pgorelik/NI_MyRIO_ExpansionBoard/README.md

# NI_MyRIO_ExpansionBoard
Breakout board with lick detection, solenoid driving and lights
