pgorelik/NI_MyRIO_ExpansionBoard/PCB-Eagle/MyRIO Expansion Board BOM Ver G2a.pdf

### MyRIO Expansion Board

(Gamma2a, 2018)

Name | Value | Package | Description | Part Number
C1, C2, C3 | 220 uF (50V) | Radial | Buckpuck cap | P5183-ND
C4, C5, C8, C9 | .1 uF? | 0805 | LP filter
C6 | .1 uF | Radial | Vreg output cap
C7 | .33 uF 50V | Radial | Vreg input cap
C10 | .1 uF | 0805 | Comparator bypass cap
D1 | 2A, 200V | Through hole | Input reverse polarity protection diode | RL203-TPCT-ND (http://www.digikey.com/product-detail/en/micro-commercial-co/RL203-TP/RL203-TPCT-ND/950500)
D2, D3 | 1A, 100V | SMB | SB1100 solenoid flyback Schottky diode | MBRS1100T3GOSCT-ND (https://www.digikey.com/product-detail/en/on-semiconductor/MBRS1100T3G/MBRS1100T3GOSCT-ND/917998)
D2, D3 | 3A, 60V | SMB | Fast recovery Schottky diode for coils. MBRS360 | MBRS360BT3GOSCT-ND (https://www.digikey.com/product-detail/en/on-semiconductor/MBRS360BT3G/MBRS360BT3GOSCT-ND/2623453)
D4, D5 | 40V | SOT23 | Lick FET Protection Schottky diode | BAS40-04-E3-08CT-ND (https://www.digikey.com/product-detail/en/vishay-semiconductor-diodes-division/BAS40-04-E3-08/BAS40-04-E3-08CT-ND/3104412)
D4, D5 | 40V | SOT23 | Upgraded lick FET Protection Schottky diode array with higher Vr max | CMPD2004SCT-ND (https://www.digikey.com/product-detail/en/central-semiconductor-corp/CMPD2004S-TR/CMPD2004SCT-ND/4807037)
Q1, Q3 | 500mA, 60V | SOT23 | MMBF170 NFET for lick detection | MMBF170CT-ND (https://www.digikey.com/product-detail/en/fairchild-on-semiconductor/MMBF170/MMBF170CT-ND/244295)
Q1, Q3 | 500mA, 60V | SOT23 | Improved NFET for lick detection with higher VDS max | DMN24H3D5L-7DICT-ND (https://www.digikey.com/product-detail/en/diodes-incorporated/DMN24H3D5L-7/DMN24H3D5L-7DICT-ND/5126865)
Q2, Q4 | 200mA, 40V | SOT23 | 2N3906 PNP for lick detection | MMBT3906FSCT-ND (http://www.digikey.com/product-search/en?keywords=MMBT3906FSCT-ND)
Q5, Q7, Q9 | 200mA, 40V | SOT23 | 2N3906 PNP for Buckpuck ctrl | MMBT3906FSCT-ND (http://www.digikey.com/product-detail/en/micro-commercial-co/2N3906-AP/2N3906-APCT-ND/950592)
Q6, Q8, Q10 | 200mA, 40V | SOT23 | 2N3904 NPN for Buckpuck ctrl | 568-4510-1-ND (http://www.digikey.com/product-search/en?keywords=568-4510-1-ND)
T1, T2 | 60V, 4A | SOT-223 | Power NFET for soln. Alternate part with better characteristics (protection) | 497-3177-1-ND (https://www.digikey.com/product-detail/en/stmicroelectronics/STN3NF06L/497-3177-1-ND/654516) NCV8406ASTT1GOSCT-ND (https://www.digikey.com/product-detail/en/on-semiconductor/NCV8406ASTT1G/NCV8406ASTT1GOSCT-ND/5213327)
R1, R3, R38, R42 | 10M | 0805 | Lick sense resistor | HMC0805JT50M0CT-ND (https://www.digikey.com/product-detail/en/stackpole-electronics-inc/HMC0805JT50M0/HMC0805JT50M0CT-ND/2683717)
R2, R4 | 500 | 1206 | Soln FET gate drive
R30, R31 | 50k | 1206 | Soln FET pull-down
R32, R33 | 1 | 1206 | Soln current sense
R7 | 500 | axial | Power LED
R8, R15, R19, R20 | 500 | 0805 | Opto-isolator LED current limit
R5, R6, R17, R18 | 100k | 0805 | First lick sensor components
R16, R21 | 100k Pot | Bourne 3362P or 3386P Series | First lick sensor components, sensitivity adjust | 3386P-104LF-ND (http://www.digikey.com/product-detail/en/bourns-inc/3386P-1-104LF/3386P-104LF-ND/1088524) 3362P-104LF-ND (https://www.digikey.com/product-detail/en/bourns-inc/3362P-1-104LF/3362P-104LF-ND/1088413)

R9, R10, R11, R12, R13, R14, R24, R27, R29 | 5k | 0805 | Buckpuck control
R23,R26 | 1M | Trimpot | Hysteresis adjust
R22, R25, R28, R34 | 10k | 0805 | Lick sensor LP
R35, R39 | 30k | | Comparator output pull-up
R36, R37, R40, R41 | 100k | | Comparator lick circuit
OK1-OK4 | Opto isolator | 6-SMD | 4N25SM | 4N25SM-ND (https://punchout.digikey.com/scripts/DkSearch/dksus.dll?Detail&itemSeq=201813650&uq=636039235491687696)
U1 | TVS | SOT-143 | TVS Protection diode for lick FETs | CD143A-SR12CT-ND (https://www.digikey.com/product-detail/en/bourns-inc/CD143A-SR12/CD143A-SR12CT-ND/1630596)
U2 | Comparator | 14-SOIC | LP339 open collector, 4 device. Can probably use LM339 or other comparator | 296-14609-1-ND (https://www.digikey.com/product-detail/en/texas-instruments/LP339DR/296-14609-1-ND/555655) 296-6604-1-ND (https://www.digikey.com/product-detail/en/texas-instruments/LM339ADR/296-6604-1-ND/404682)
U3 | 5V LDO Regulator | DPAK | MC78M05 | 497-7255-1-ND (https://www.digikey.com/product-detail/en/stmicroelectronics/L7805CDT-TR/497-7255-1-ND/1884014)
| Right Angle BNC Double | | | ARF2111-ND (http://www.digikey.com/product-search/en?keywords=arf2111-nd) ACX2286-ND (https://www.digikey.com/product-detail/en/amphenol-rf-division/112705/ACX2286-ND/3995586)
| Right Angle BNC | | | A97553-ND, (http://www.digikey.com/product-detail/en/1-1337543-0/A97553-ND/1755940) WM5514-ND (https://www.digikey.com/product-detail/en/molex-llc/0731375003/WM5514-ND/1465136)
| NI MXP Connector | | | S9207-ND (http://www.digikey.com/product-detail/en/SFH11-PBPC-D17-RA-BK/S9207-ND/1990100)
| Audio jack | | | CP1-3525N-ND (http://www.digikey.com/product-detail/en/SJ1-3525N/CP1-3525N-ND/738687)
| DC Barrel Connector | | | EJ503A-ND (https://www.digikey.com/product-detail/en/mpd-memory-protection-devices/EJ503A/EJ503A-ND/5431753)
| Switch SPDT | | EG2478 | EG1906-ND (http://www.digikey.com/product-detail/en/e-switch/EG1213/EG1906-ND/101735) EG2478-ND (https://www.digikey.com/product-detail/en/e-switch/500SSP1S1M6QEA/EG2478-ND/378947)
| Switch 3PDT | | To select battery power. | CKN1526-ND (https://www.digikey.com/product-detail/en/c-k/E301SD1CBE/CKN1526-ND/484059) CKN1525-ND (https://www.digikey.com/product-detail/en/c-k/E301MD1AGE/CKN1525-ND/484058) 360-3209-ND (https://www.digikey.com/product-detail/en/nkk-switches/M2033SS1W03/360-3209-ND/1027306) 563-1651-ND (https://www.digikey.com/product-detail/en/nidec-copal-electronics/8A3022-Z/563-1651-ND/5086616)
| | 14-SOIC | CD40106B Schmitt Trigger for lick sense | 296-14081-1-ND (https://www.digikey.com/product-detail/en/texas-instruments/CD40106BM96/296-14081-1-ND/525857)
| | 8-SOIC | LT1490A Op-amp for lick sense | LT1490ACS8#PBF-ND (https://www.digikey.com/product-detail/en/linear-technology/LT1490ACS8-PBF/LT1490ACS8-PBF-ND/962421)
| | SIP-7 | Buckpuck 350 mA, internal current adjustment pot | 788-1098-ND (https://www.digikey.com/product-detail/en/leddynamics-inc/3021-D-I-350/788-1098-ND/3114462)

Notes:

1. Replaced Q1, Q3 NPN with BS170 nFETs. Several have died, likely due to static. Need protection diodes
2. Improve labeling on led BNC terminals.
3. Upgraded Q1, Q3 to DMN24H3D5L (240V) and upgraded protection diodes to CMPD2004S (240V). Later upgraded to TVS data line ESD protection via CD143A

ToDo:

1. Revise part #s
2. Spread out lick detection circuit
3. Add John’s lick detection circuit with threshold adjust?
4. Shift RIO connectors by ~1.2mm
5. Bigger ampacity on/off switch
6. Move audio connectors
7. Shift Schottky diodes left, put labels on solenoid connectors. Include Soln voltage markings.

Version History:

Gamma

1. Protection diodes on Fet gates
2. Alternate lick detection circuit included
3. Power transistors for solenoid actuation
4. Included switch and indicator to select lick circuit power/isolation
