pgorelik/NI_MyRIO_ExpansionBoard/LickDetectorSubCkt_IsolatedDiscreteComponents.brd

## EAGLE design LickDetectorSubCkt_IsolatedDiscreteComponents.brd (2017-06-01)

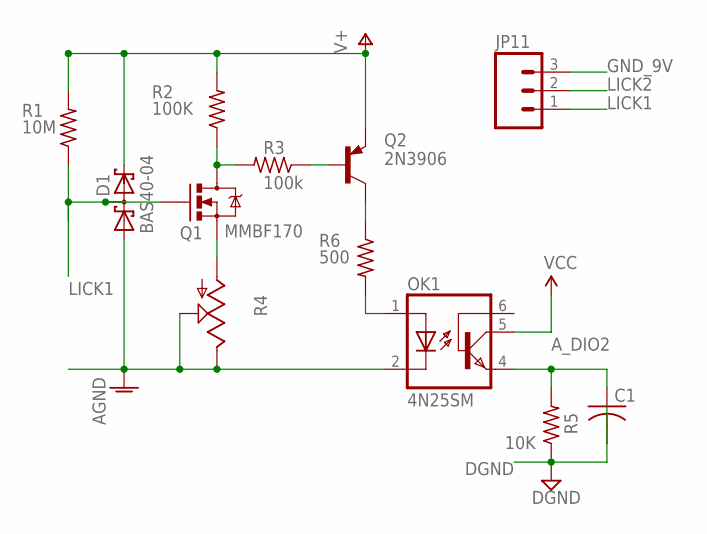
[picture p1: schematic LickDetectorSubCkt_IsolatedDiscreteComponents.sch]

Parts:
C1: C-US025-024X044; C025-024X044
D1: BAS40-04; SOT23
JP11: M03POLAR; MOLEX-1X3
OK1: 4N25SM; DIL6-SMD
Q1: MMBF170; SOT23-3
Q2: 2N3906; SOT23-BEC
R1: 10M; 0805S
R2: 100K; 0805S
R3: 100k; 0805S
R4: TRIM_US-B25P; B25P
R5: 10K; 0805S
R6: 500; 0805S

Connections:
AGND: D1.1 (A1), OK1.2 (C), R4.E, R4.S
A_DIO2: C1.1, OK1.4 (EMI), R5.2
DGND: C1.2, R5.1
GND_9V: JP11.3
LICK1: D1.3 (C1A2), JP11.1, Q1.1 (G), R1.1
LICK2: JP11.2
unnamed: Q1.2 (S), R4.A
unnamed: Q1.3 (D), R2.1, R3.2
unnamed: Q2.B, R3.1
unnamed: OK1.1 (A), R6.2
unnamed: Q2.C, R6.1
V+: D1.2 (C2), Q2.E, R1.2, R2.2
VCC: OK1.5 (COL)

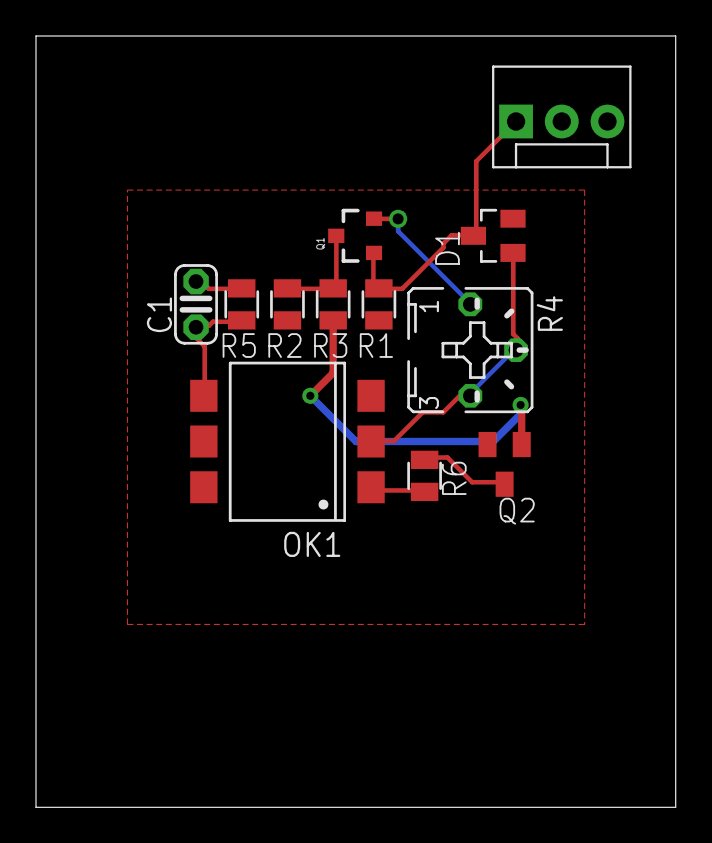
[picture p2: board LickDetectorSubCkt_IsolatedDiscreteComponents.brd from above]

Board: 2 copper layers, 35.5 x 42.9 mm, 12 parts (0 on the bottom side), 10 nets.
