pgorelik/NI_MyRIO_ExpansionBoard/MyRIO_LickometerBreakout_Gamma1a.brd

## EAGLE design MyRIO_LickometerBreakout_Gamma1a.brd (2017-06-01)

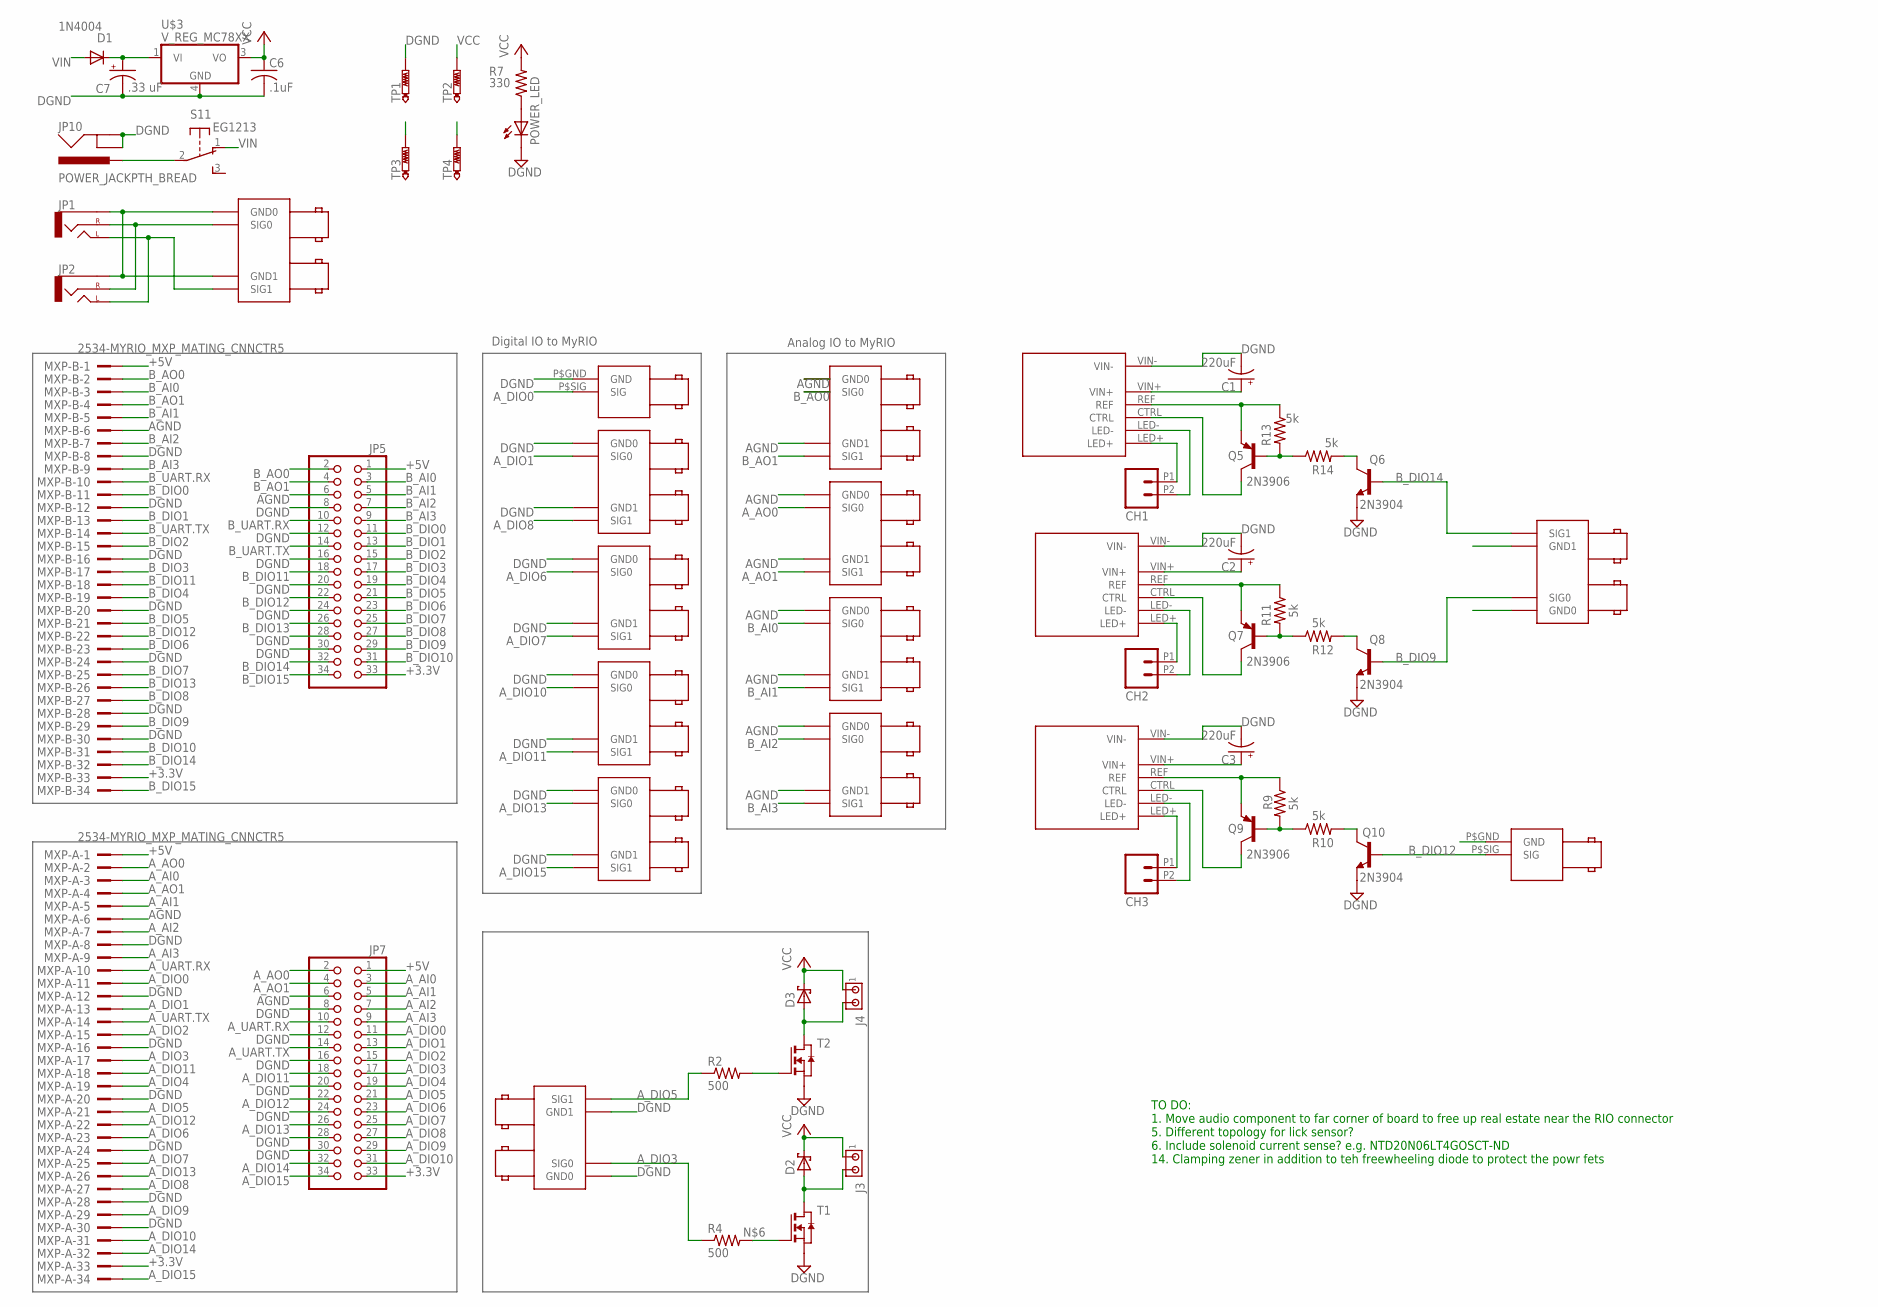
[picture p3: schematic MyRIO_LickometerBreakout_Gamma1a.sch, sheet 1]

Parts:
AAO_0,1: BNC_RIGHT_ANGLE_DOUBLE
ACTV_REC: BNC_RIGHT_ANGLE
AUDIO: BNC_RIGHT_ANGLE_DOUBLE
BAI_0,1, BAI_2,3: BNC_RIGHT_ANGLE_DOUBLE
BAO_0,1: BNC_RIGHT_ANGLE_DOUBLE
BUCKPUCK1, BUCKPUCK2, BUCKPUCK3: BUCKPUCK-350-I; BUCKPUCK_I
C1, C2, C3: 220uF; E5-10,5
C6: .1uF; C0805
C7: .33 uF; E2,5-5
CAMERA: BNC_RIGHT_ANGLE_DOUBLE
CH1, CH2, CH3: M022.54MM_SCREWTERM; 1X02_2.54_SCREWTERM
D1: 1N4004; DO41-10
D2, D3: SCHOTTKY-DIODE; DIODE_SMB
D_FREE1_2, D_FREE3_4: BNC_RIGHT_ANGLE_DOUBLE
J3, J4: MTA02-100; 10X02MTA
JP1, JP2: AUDIO-JACKPTH; AUDIO-JACK
JP5, JP7: PINHD-2X17; 2X17
JP10: POWER_JACKPTH_BREAD; POWER_JACK_PTH_BREAD
LED_CUE: BNC_RIGHT_ANGLE
LED_MASK: BNC_RIGHT_ANGLE_DOUBLE
MXP-A: 2534-MYRIO_MXP_MATING_CNNCTR5; PAK100/2500-5-34-MXP_CONNCTR
MXP-B: 2534-MYRIO_MXP_MATING_CNNCTR5; PAK100/2500-5-34-MXP_CONNCTR
POWER_LED: LED3MM
Q5, Q7, Q9: 2N3906; SOT23-BEC
Q6, Q8, Q10: 2N3904; SOT23-BEC
R2, R4: 500; M1206
R7: 330; 0805S
R9, R10, R11, R12, R13, R14: 5k; 0805S
S1: EG1213
SHUTTER: BNC_RIGHT_ANGLE_DOUBLE
SLN: BNC_RIGHT_ANGLE_DOUBLE
T1, T2: NMOSSOT223; SOT223
TP1, TP2, TP3, TP4: PTR1PAD1-17Y; P1-17Y
U$3: V_REG_MC78XX; DPAK

Connections:
+3.3V: JP5.33, JP7.33, MXP-A.33, MXP-B.33
+5V: JP5.1, JP7.1, MXP-A.1, MXP-B.1; also elsewhere on the board
+9V: TP4.TP; also elsewhere on the board
AGND: AAO_0,1.P$GND0 (GND0), AAO_0,1.P$GND1 (GND1), BAI_0,1.P$GND0 (GND0), BAI_0,1.P$GND1 (GND1), BAI_2,3.P$GND0 (GND0), BAI_2,3.P$GND1 (GND1), BAO_0,1.P$GND0 (GND0), BAO_0,1.P$GND1 (GND1), JP5.6, JP7.6, MXP-A.6, MXP-B.6
A_AI0: JP7.3, MXP-A.3
A_AI1: JP7.5, MXP-A.5
A_AI2: JP7.7, MXP-A.7
A_AI3: JP7.9, MXP-A.9
A_AO0: AAO_0,1.P$SIG0 (SIG0), JP7.2, MXP-A.2
A_AO1: AAO_0,1.P$SIG1 (SIG1), JP7.4, MXP-A.4
A_DIO0: ACTV_REC.P$SIG (SIG), JP7.11, MXP-A.11
A_DIO1: CAMERA.P$SIG0 (SIG0), JP7.13, MXP-A.13
A_DIO2: JP7.15, MXP-A.15; also elsewhere on the board
A_DIO3: JP7.17, MXP-A.17, R4.1, SLN.P$SIG0 (SIG0)
A_DIO4: JP7.19, MXP-A.19; also elsewhere on the board
A_DIO5: JP7.21, MXP-A.21, R2.1, SLN.P$SIG1 (SIG1)
A_DIO6: JP7.23, MXP-A.23, SHUTTER.P$SIG0 (SIG0)
A_DIO7: JP7.25, MXP-A.25, SHUTTER.P$SIG1 (SIG1)
A_DIO8: CAMERA.P$SIG1 (SIG1), JP7.27, MXP-A.27
A_DIO9: JP7.29, MXP-A.29
A_DIO10: D_FREE1_2.P$SIG0 (SIG0), JP7.31, MXP-A.31
A_DIO11: D_FREE1_2.P$SIG1 (SIG1), JP7.18, MXP-A.18
A_DIO12: JP7.22, MXP-A.22
A_DIO13: D_FREE3_4.P$SIG0 (SIG0), JP7.26, MXP-A.26
A_DIO14: JP7.32, MXP-A.32
A_DIO15: D_FREE3_4.P$SIG1 (SIG1), JP7.34, MXP-A.34
A_UART.RX: JP7.10, MXP-A.10
A_UART.TX: JP7.14, MXP-A.14
BCKPCK_CTRL2: Q8.C, R12.2
BCKPCK_CTRL3: Q10.C, R10.2
B_AI0: BAI_0,1.P$SIG0 (SIG0), JP5.3, MXP-B.3
B_AI1: BAI_0,1.P$SIG1 (SIG1), JP5.5, MXP-B.5
B_AI2: BAI_2,3.P$SIG0 (SIG0), JP5.7, MXP-B.7
B_AI3: BAI_2,3.P$SIG1 (SIG1), JP5.9, MXP-B.9
B_AO0: BAO_0,1.P$SIG0 (SIG0), JP5.2, MXP-B.2
B_AO1: BAO_0,1.P$SIG1 (SIG1), JP5.4, MXP-B.4
B_DIO0: JP5.11, MXP-B.11
B_DIO1: JP5.13, MXP-B.13
B_DIO2: JP5.15, MXP-B.15
B_DIO3: JP5.17, MXP-B.17
B_DIO4: JP5.19, MXP-B.19
B_DIO5: JP5.21, MXP-B.21
B_DIO6: JP5.23, MXP-B.23
B_DIO7: JP5.25, MXP-B.25
B_DIO8: JP5.27, MXP-B.27
B_DIO9: JP5.29, LED_MASK.P$SIG0 (SIG0), MXP-B.29, Q8.B
B_DIO10: JP5.31, MXP-B.31
B_DIO11: JP5.18, MXP-B.18
B_DIO12: JP5.22, LED_CUE.P$SIG (SIG), MXP-B.22, Q10.B
B_DIO13: JP5.26, MXP-B.26
B_DIO14: JP5.32, LED_MASK.P$SIG1 (SIG1), MXP-B.32, Q6.B
B_DIO15: JP5.34, MXP-B.34
B_UART.RX: JP5.10, MXP-B.10
B_UART.TX: JP5.14, MXP-B.14
CTRL1: BUCKPUCK1.CTRL, Q5.C
CTRL2: BUCKPUCK2.CTRL, Q7.C
CTRL3: BUCKPUCK3.CTRL, Q9.C
DGND: ACTV_REC.P$GND (GND), BUCKPUCK1.LED-, BUCKPUCK1.VIN-, BUCKPUCK2.LED-, BUCKPUCK2.VIN-, BUCKPUCK3.LED-, BUCKPUCK3.VIN-, C1.-, C2.-, C3.-, C6.2, C7.-, CAMERA.P$GND0 (GND0), CAMERA.P$GND1 (GND1), CH1.P2 (2), CH2.P2 (2), CH3.P2 (2), D_FREE1_2.P$GND0 (GND0), D_FREE1_2.P$GND1 (GND1), D_FREE3_4.P$GND0 (GND0), D_FREE3_4.P$GND1 (GND1), JP5.8, JP5.12, JP5.16, JP5.20, JP5.24, JP5.28, JP5.30, JP7.8, JP7.12, JP7.16, JP7.20, JP7.24, JP7.28, JP7.30, JP10.GND, JP10.GNDBREAK, LED_CUE.P$GND (GND), LED_MASK.P$GND0 (GND0), LED_MASK.P$GND1 (GND1), MXP-A.8, MXP-A.12, MXP-A.16, MXP-A.20, MXP-A.24, MXP-A.28, MXP-A.30, MXP-B.8, MXP-B.12, MXP-B.16, MXP-B.20, MXP-B.24, MXP-B.28, MXP-B.30, POWER_LED.K (C), Q6.E, Q8.E, Q10.E, SHUTTER.P$GND0 (GND0), SHUTTER.P$GND1 (GND1), SLN.P$GND0 (GND0), SLN.P$GND1 (GND1), T1.3 (S), T2.3 (S), TP1.TP, U$3.4 (GND); also elsewhere on the board
GND-ISO: TP3.TP; also elsewhere on the board
LED3+: BUCKPUCK3.LED+, CH3.P1 (1)
unnamed: R2.2, T2.1 (G)
unnamed: AUDIO.P$GND0 (GND0), AUDIO.P$GND1 (GND1), JP1.SLEEVE, JP2.SLEEVE
unnamed: AUDIO.P$SIG0 (SIG0), JP1.RING (RIGHT), JP2.RING (RIGHT)
unnamed: AUDIO.P$SIG1 (SIG1), JP1.TIP (LEFT), JP2.TIP (LEFT)
unnamed: R4.2, T1.1 (G)
unnamed: BUCKPUCK3.REF, Q9.E, R9.1
unnamed: BUCKPUCK1.LED+, CH1.P1 (1)
unnamed: Q9.B, R9.2, R10.1
unnamed: BUCKPUCK1.VIN+, BUCKPUCK2.VIN+, BUCKPUCK3.VIN+, C1.+, C2.+, C3.+, C7.+, D1.C, U$3.1 (VI)
unnamed: BUCKPUCK2.LED+, CH2.P1 (1)
unnamed: POWER_LED.A, R7.1
unnamed: BUCKPUCK1.REF, Q5.E, R13.1
unnamed: BUCKPUCK2.REF, Q7.E, R11.1
unnamed: Q5.B, R13.2, R14.1
unnamed: Q7.B, R11.2, R12.1
unnamed: JP10.PWR, S1.2
unnamed: Q6.C, R14.2
VCC: C6.1, D2.C (A), D3.C (A), J3.1, J4.1, R7.2, TP2.TP, U$3.3 (VO)
VIN: D1.A, S1.1 (O)
VOUT-1: D2.A (C), J3.2, T1.2 (D), T1.4 (D)
VOUT-2: D3.A (C), J4.2, T2.2 (D), T2.4 (D)

Notes on the sheet:
Digital IO to MyRIO
Analog IO to MyRIO
TO DO: 1. Move audio component to far corner of board to free up real estate near the RIO connector 5. Different topology for lick sensor? 6. Include solenoid current sense? e.g. NTD20N06LT4GOSCT-ND 14. Clamping zener in addition to teh freewheeling diode to protect the powr fets

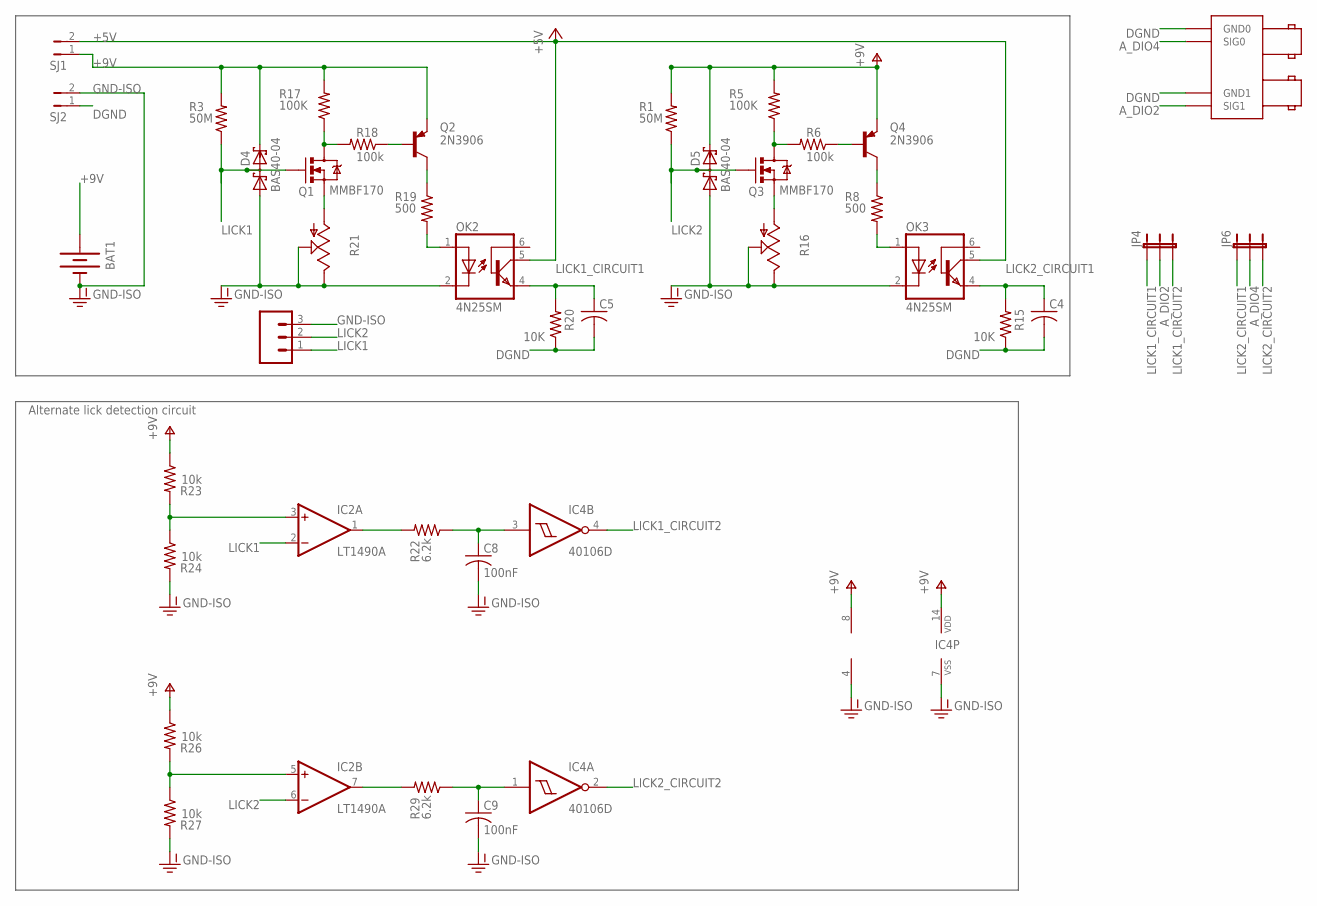
[picture p4: schematic MyRIO_LickometerBreakout_Gamma1a.sch, sheet 2]

Parts:
BAT1: BATTERY9V; BATTCON_9V
C4, C5: C-US025-024X044; C025-024X044
C8, C9: 100nF; C0805
D4, D5: BAS40-04; SOT23
IC2: LT1490A; SO08
IC4: 40106D; SO14
JP4, JP6: JUMPER-3PTH; 1X03
JP11: M03POLAR; MOLEX-1X3
LICK: BNC_RIGHT_ANGLE_DOUBLE
OK2, OK3: 4N25SM; DIL6-SMD
Q1, Q3: MMBF170; SOT23-3
Q2, Q4: 2N3906; SOT23-BEC
R1, R3: 50M; 0805S
R5, R17: 100K; 0805S
R6, R18: 100k; 0805S
R8, R19: 500; 0805S
R15, R20: 10K; 0805S
R16, R21: TRIM_US-B25P; B25P
R22, R29: 6.2k; 0805S
R23, R24, R26, R27: 10k; 0805S
SJ1, SJ2: JUMPER-PTH-2-NO; PTH-JUMPER-2-NO_NO_SILK

Connections:
+5V: OK2.5 (COL), OK3.5 (COL), SJ1.2; also elsewhere on the board
+9V: BAT1.+, D4.2 (C2), D5.2 (C2), IC2.8 (V+), IC4.14 (VDD), Q2.E, Q4.E, R1.2, R3.2, R5.2, R17.2, R23.1, R26.1, SJ1.1; also elsewhere on the board
A_DIO2: JP4.2, LICK.P$SIG1 (SIG1); also elsewhere on the board
A_DIO4: JP6.2, LICK.P$SIG0 (SIG0); also elsewhere on the board
DGND: C4.2, C5.2, LICK.P$GND0 (GND0), LICK.P$GND1 (GND1), R15.1, R20.1, SJ2.1; also elsewhere on the board
GND-ISO: BAT1.-, C8.2, C9.2, D4.1 (A1), D5.1 (A1), IC2.4 (V-), IC4.7 (VSS), JP11.3, OK2.2 (C), OK3.2 (C), R16.E, R16.S, R21.E, R21.S, R24.2, R27.2, SJ2.2; also elsewhere on the board
LICK1: D4.3 (C1A2), IC2.2 (-IN), JP11.1, Q1.1 (G), R3.1
LICK1_CIRCUIT1: C5.1, JP4.1, OK2.4 (EMI), R20.2
LICK1_CIRCUIT2: IC4.4 (O), JP4.3
LICK2: D5.3 (C1A2), IC2.6 (-IN), JP11.2, Q3.1 (G), R1.1
LICK2_CIRCUIT1: C4.1, JP6.1, OK3.4 (EMI), R15.2
LICK2_CIRCUIT2: IC4.2 (O), JP6.3
unnamed: Q1.3 (D), R17.1, R18.2
unnamed: Q3.3 (D), R5.1, R6.2
unnamed: Q4.B, R6.1
unnamed: OK3.1 (A), R8.2
unnamed: Q4.C, R8.1
unnamed: Q3.2 (S), R16.A
unnamed: Q2.B, R18.1
unnamed: OK2.1 (A), R19.2
unnamed: Q2.C, R19.1
unnamed: Q1.2 (S), R21.A
unnamed: C8.1, IC4.3 (I), R22.1
unnamed: IC2.1 (OUT), R22.2
unnamed: IC2.3 (+IN), R23.2, R24.1
unnamed: IC2.5 (+IN), R26.2, R27.1
unnamed: C9.1, IC4.1 (I), R29.1
unnamed: IC2.7 (OUT), R29.2

Notes on the sheet:
Alternate lick detection circuit

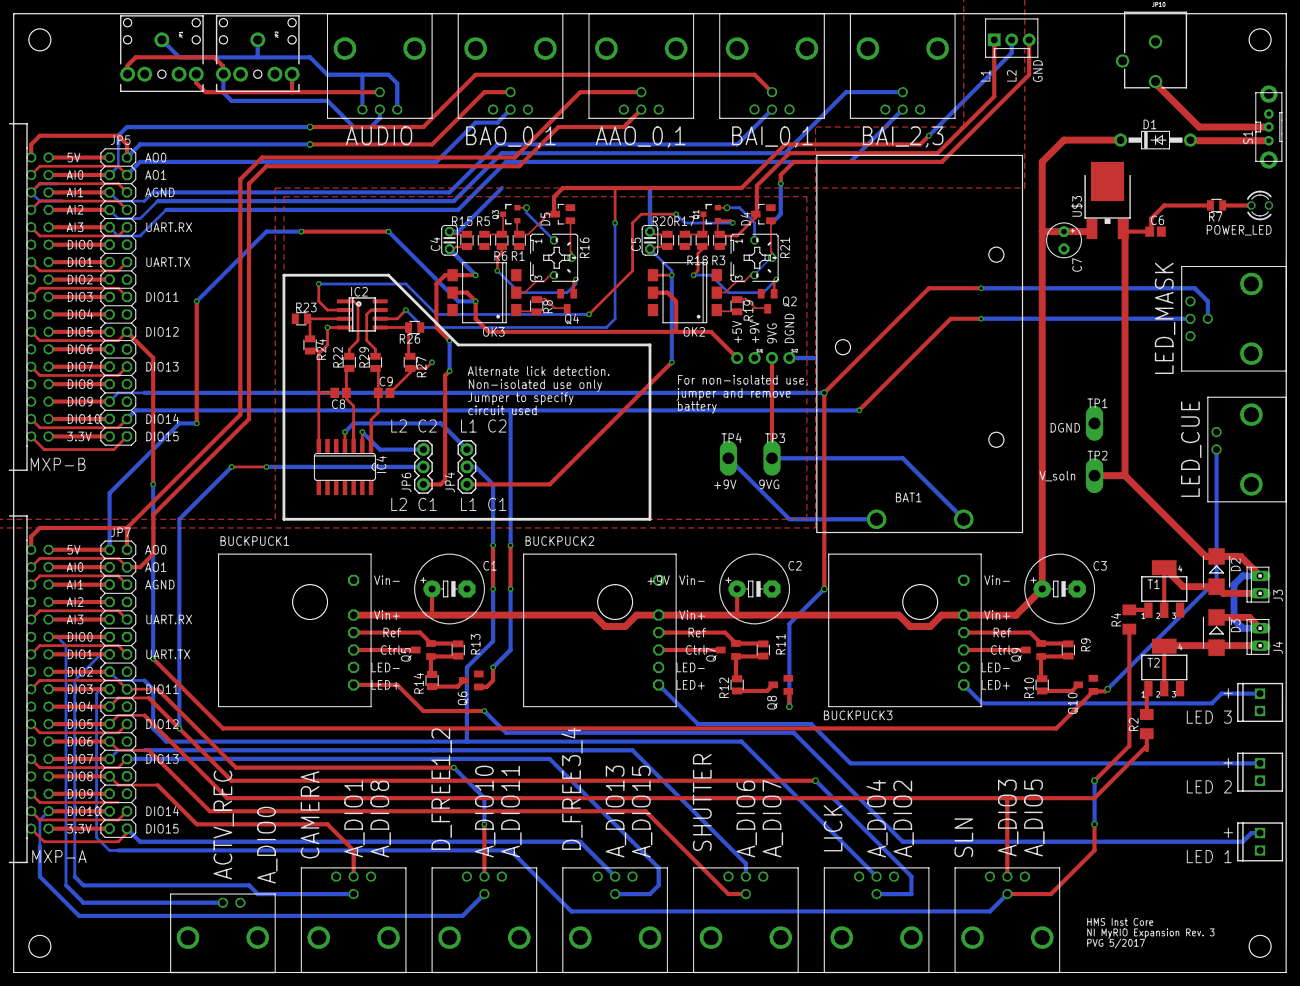
[picture p5: board MyRIO_LickometerBreakout_Gamma1a.brd from above]

Board: 2 copper layers, 185.4 x 139.7 mm, 99 parts (0 on the bottom side), 103 nets.
