pgorelik/NI_MyRIO_ExpansionBoard/LED_Driver_SubCkt.brd

## EAGLE design LED_Driver_SubCkt.brd (2017-06-01)

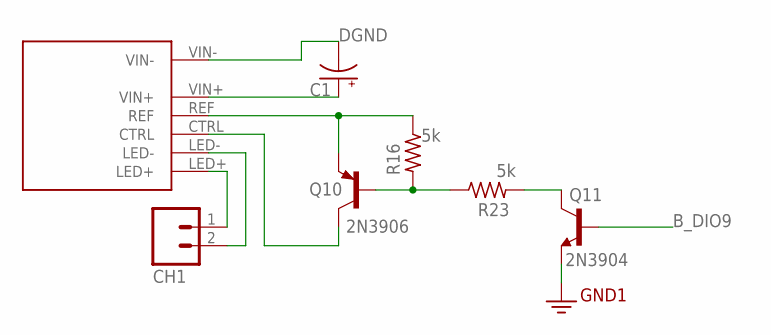
[picture p6: schematic LED_Driver_SubCkt.sch]

Parts:
BUCKPUCK1: BUCKPUCK-350-I; BUCKPUCK_I
C1: CPOL-USE5-10.5; E5-10,5
CH1: M023.5MM_LOCK; SCREWTERMINAL-3.5MM-2_LOCK
Q10: 2N3906; SOT23-BEC
Q11: 2N3904; SOT23-BEC
R16, R23: 5k; 0805S

Connections:
B_DIO9: Q11.B
CTRL1: BUCKPUCK1.CTRL, Q10.C
DGND: BUCKPUCK1.LED-, BUCKPUCK1.VIN-, C1.-, CH1.2, Q11.E
unnamed: BUCKPUCK1.LED+, CH1.1
unnamed: BUCKPUCK1.VIN+, C1.+
unnamed: BUCKPUCK1.REF, Q10.E, R16.1
unnamed: Q10.B, R16.2, R23.1
unnamed: Q11.C, R23.2

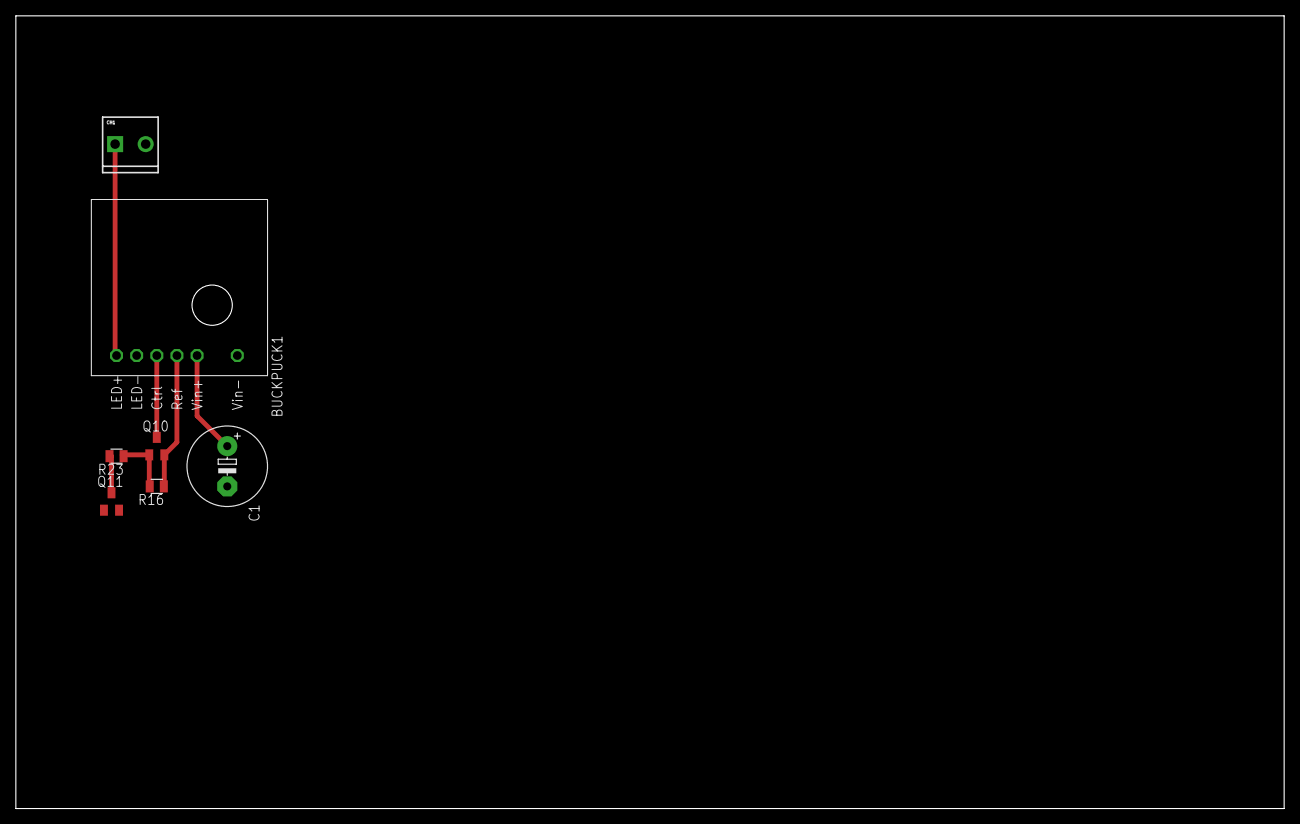
[picture p7: board LED_Driver_SubCkt.brd from above]

Board: 2 copper layers, 160.0 x 100.0 mm, 7 parts (0 on the bottom side), 7 nets.
