pgorelik/NI_MyRIO_ExpansionBoard/(commit log)

2017-06-01 Initial upload
    Includes the main board and sub-components for LED driving and lick detection
    [LED_Driver_SubCkt.brd, LED_Driver_SubCkt.sch, LickDetectorSubCkt_IsolatedDiscreteComponents.brd, LickDetectorSubCkt_IsolatedDiscreteComponents.sch, MyRIO_LickometerBreakout_Gamma1a.brd, MyRIO_LickometerBreakout_Gamma1a.sch]
2018-10-16 Create PCB-Eagle
